FelipePerez-eng/ManoTerapia/hardware/kicad/Placa.kicad_pcb

## KiCad design hardware/kicad/Placa.kicad_pcb (2026-11-08)

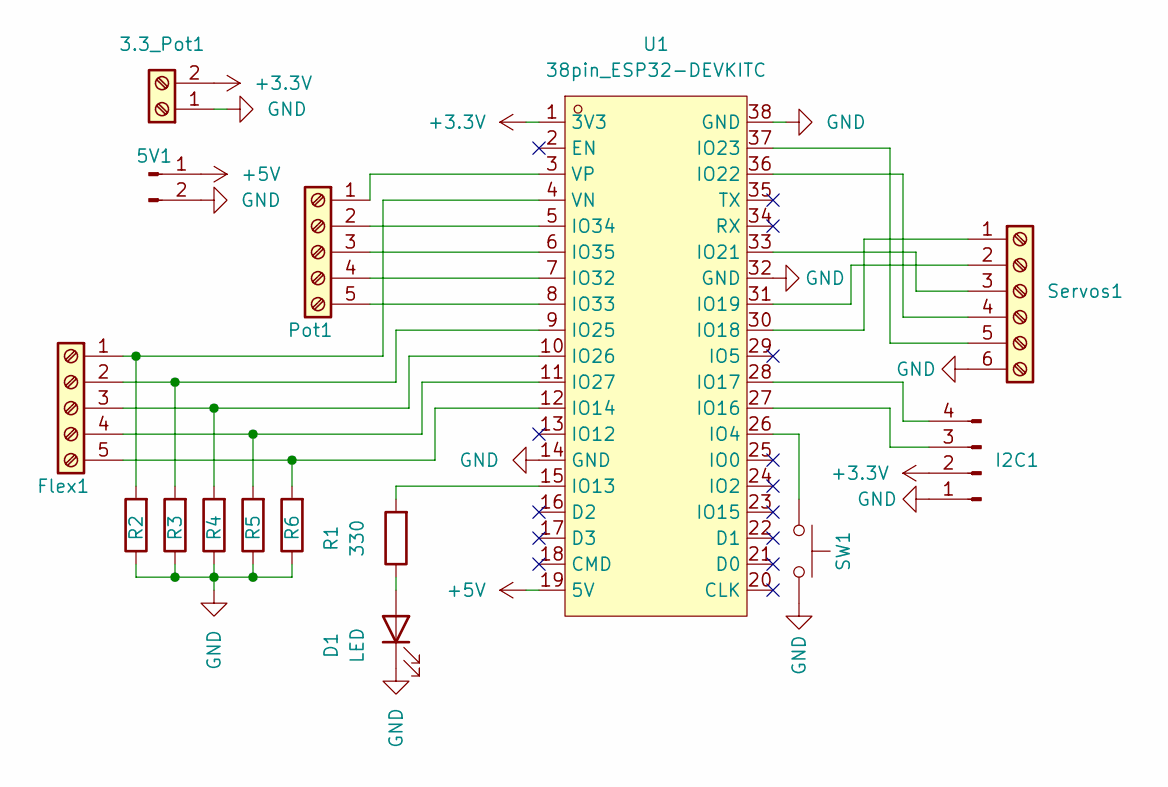
[picture p2: schematic Placa.kicad_sch]

Parts:
3.3_Pot1: Screw_Terminal_01x02; TerminalBlock_MaiXu_MX126-5.0-02P_1x02_P5.00mm
5V1: Conn_01x02_Pin; PinSocket_1x02_P2.54mm_Vertical
D1: LED; LED_D3.0mm
Flex1: Screw_Terminal_01x05; TerminalBlock_MaiXu_MX126-5.0-05P_1x05_P5.00mm
I2C1: Conn_01x04_Pin; PinHeader_1x04_P2.54mm_Vertical
Pot1: Screw_Terminal_01x05; TerminalBlock_MaiXu_MX126-5.0-05P_1x05_P5.00mm
R1, R2, R3, R4, R5, R6: 330; R_Axial_DIN0207_L6.3mm_D2.5mm_P10.16mm_Horizontal
SW1: SW_Push; SW_PUSH_6mm
Servos1: Screw_Terminal_01x06; TerminalBlock_MaiXu_MX126-5.0-06P_1x06_P5.00mm
U1: 38pin_ESP32-DEVKITC; Z_ESP32_DevKitC_38pin_socket; MPN ESP32-DevKitC; LCSC Part C571180

Connections:
+3.3V: 3.3_Pot1.2, I2C1.2, U1.1 (3V3)
+5V: 5V1.1, U1.19 (5V)
GND: 3.3_Pot1.1, 5V1.2, D1.1 (K), I2C1.1, R2.1, R3.1, R4.1, R5.1, R6.1, SW1.2, Servos1.6, U1.14 (GND), U1.32 (GND), U1.38 (GND)
unnamed: D1.2 (A), R1.1
unnamed: Flex1.1, R2.2, U1.4 (VN)
unnamed: Flex1.2, R3.2, U1.9 (IO25)
unnamed: Flex1.3, R4.2, U1.10 (IO26)
unnamed: Flex1.4, R5.2, U1.11 (IO27)
unnamed: Flex1.5, R6.2, U1.12 (IO14)
unnamed: I2C1.3, U1.27 (IO16)
unnamed: I2C1.4, U1.28 (IO17)
unnamed: Pot1.1, U1.3 (VP)
unnamed: Pot1.2, U1.5 (IO34)
unnamed: Pot1.3, U1.6 (IO35)
unnamed: Pot1.4, U1.7 (IO32)
unnamed: Pot1.5, U1.8 (IO33)
unnamed: Servos1.1, U1.30 (IO18)
unnamed: Servos1.2, U1.31 (IO19)
unnamed: Servos1.3, U1.33 (IO21)
unnamed: Servos1.4, U1.36 (IO22)
unnamed: Servos1.5, U1.37 (IO23)
unnamed: SW1.1, U1.26 (IO4)
unnamed: R1.2, U1.15 (IO13)

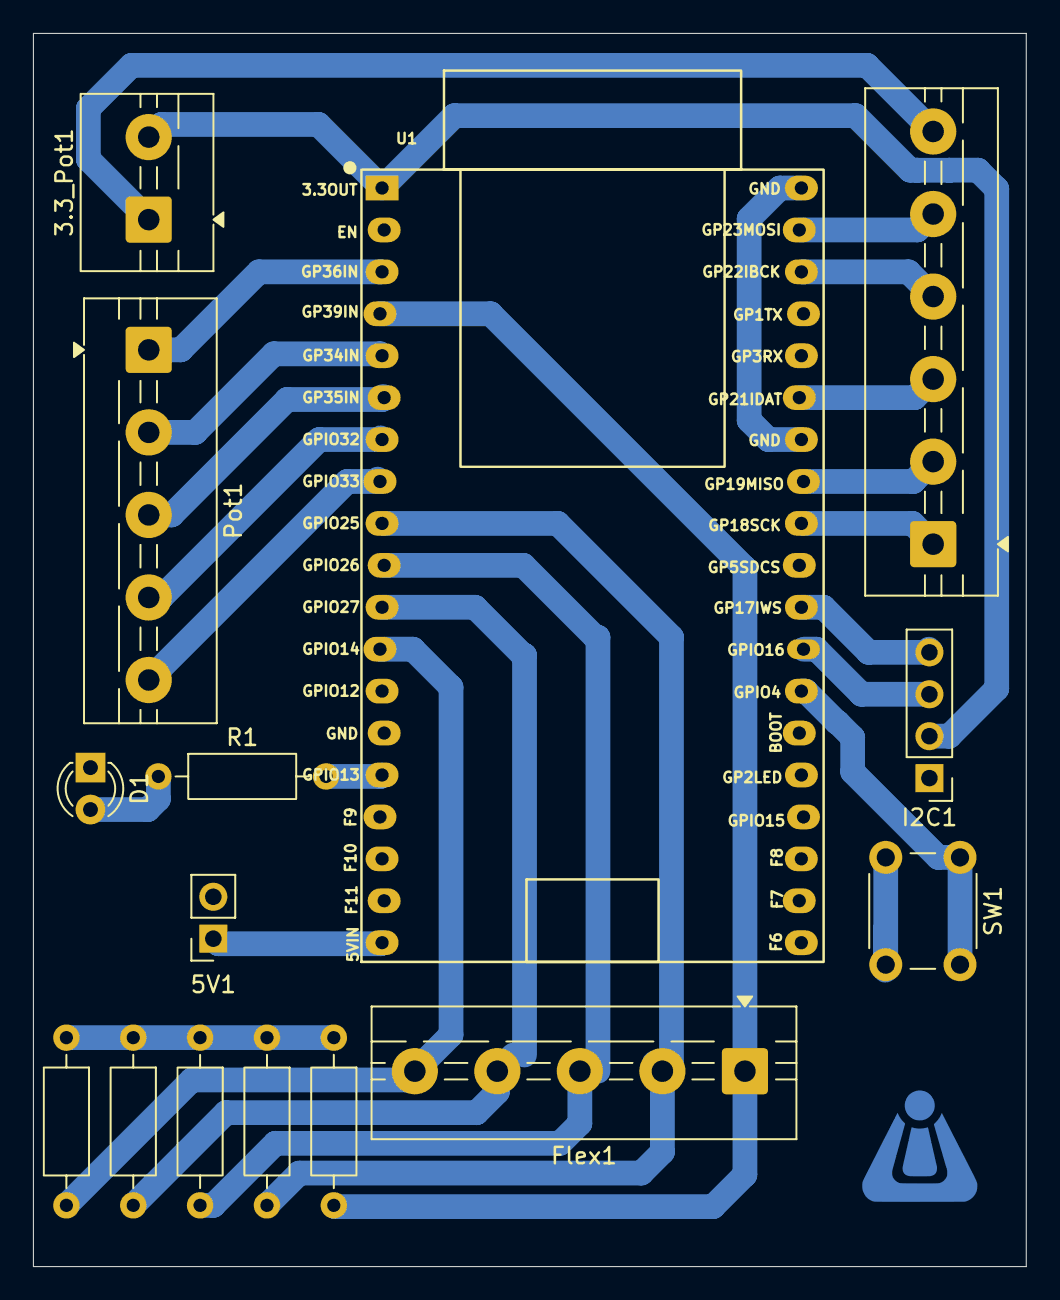
[picture p3: board Placa.kicad_pcb from above]

Board: 2 copper layers, 60.1 x 74.7 mm, 16 parts (1 on the bottom side), 23 nets.

Other parts of the board:
-: LOGO
