FelipePerez-eng/ManoTerapia/(commit log)

2026-11-07 Guardar dashboard V2, respaldos, firmware de referencia y documentación
    Conservar instantáneas V1/V2 disponibles y pruebas simuladas. Registrar identidad METIE, gestos adicionales y límites de verificación física.
2026-11-08 Añadir registro pasivo para investigar apagado de servos sin modificar firmware
2026-11-08 Conservar cambios de estado sin saturar el diagnóstico con mensajes repetidos
2026-11-08 Añadir variante con antirrebote estable de 60 ms y trazas de origen; conservar pines y calibración
2026-11-08 Documentar conexiones confirmadas sin flex y límites de la corrección de antirrebote
2026-11-08 Documentar extremos medidos, prueba sin servos y límite de lecturas fijas en 4095
2026-11-08 Añadir filtro adaptativo de potenciómetros conservando calibración, recorridos y antirrebote
2026-11-08 Conservar firmware funcional aportado por el usuario con pines de servos corregidos
2026-11-08 Actualizar calibración y seguir antes cambios pequeños con órdenes de servo graduales
2026-11-08 Documentar pines confirmados, respuesta suave y límites de las pruebas
2026-11-08 Ajustar seguimiento a velocidad intermedia: paso manual de 3 a 4 grados
2026-11-08 Mostrar lecturas por dedo en rutinas y ajustar margen de flexión intermedia; validar continuidad de datos
2026-11-08 Documentar reconocimiento de posición intermedia, pruebas y limitaciones
2026-11-08 Retirar panel y registro de diagnóstico conservando rutinas ajustadas y funciones operativas
2026-11-08 Documentar reducción de saltos y prueba pendiente del pulsador físico
2026-11-08 Desplegar opciones de gestos en tarjeta y exigir finalización explícita antes de navegar
2026-11-08 Documentar interacción de gestos, bloqueo elegido por usuario y pruebas de finalización
2026-11-08 Sustituir expansión de tarjetas por ventana flotante minimizable y conservar finalización explícita
2026-11-08 Organizar proyecto: una versión vigente, KiCad completo y README de uso
    Conservar versiones anteriores en el historial sin reescribirlo. Agrupar dashboard, firmware, hardware, documentación y pruebas portables. Incorporar Placa de KiCad con bibliotecas relativas; documentar MG90S, fuente de 5 V y pendientes eléctricos sin cambiar código operativo ni trazado.
    [Placa.kicad_pcb, Placa.kicad_sch]
2026-11-08 Inicializar servos según lecturas actuales antes de attach y documentar revisión eléctrica
    Conservar calibración, pines, antirrebote y límites. Añadir pruebas simuladas de arranque y dejar constancia del ERC sin detalle recuperable; sin modificar PCB ni atribuir una causa confirmada a los saltos.
2026-11-08 Conservar edición local del esquema aportada por el usuario
    Registrar el esquema vigente sin modificarlo; no incluir preferencias ni historial interno de KiCad. PCB y firmware sin cambios.
    [Placa.kicad_sch]
2026-11-08 Exigir servos activos confirmados durante las rutinas y permitir reanudar tras pausa
    Esperar estado ON/ROUTINE, bloquear evaluación sin servos, conservar paso al pausar y manejar timeout/desconexión. Mantener firmware y edición del esquema del usuario.
2026-11-08 Añadir imagen del esquemático a la sección KiCad del README
2026-11-08 Usar enlace público al esquemático para mostrarlo también desde el README local
2026-11-08 Añadir licencia MIT, autoría del equipo, cita académica y declaración de asistencia de IA
    Aplicar MIT a código y documentación originales según elección delegada por el usuario. Conservar derechos de materiales de terceros y distinguir solicitud de cita académica de condiciones de licencia.
